Dulina14/-A-multi-RF-head-receiver-array-for-AI-native-sensing-and-communications/docs/group-documents/One_Page_Abstract.docx

# A Multi-RF-Head Receiver Array for AI-Native Integrated Sensing and Communications

D. M. B. P. Anuradha, W. A. A. P. Weragoda, R. P. D. D. H. Ranaweera, and P. I. U. Peiris

Department of Electronic and Telecommunication Engineering, University of Moratuwa, Sri Lanka

Supervisors: Prof. Arjuna Madanayake and Dr. Chamira U. S. Edussooriya

Emerging wireless platforms increasingly require the same radio infrastructure to support high-data-rate communications, environmental sensing, spectrum monitoring, localization, and target classification. Conventional implementations commonly use separate RF front ends for these functions, increasing hardware duplication and limiting cross-band experimentation. This project proposes a modular multi-RF-head receiver array for integrated sensing and communications (ISAC), with a common, software-configurable processing platform that can be adapted to communication, radar, and spectrum-intelligence experiments.

The proposed hardware covers approximately 0.8-8 GHz through four band-oriented RF heads: 0.8-1.6 GHz, 1-3 GHz, 2-8 GHz, and 5.7-6.0 GHz. Broadband Vivaldi arrays are considered for the wideband heads, while a 16-element microstrip patch array is investigated near 5.8 GHz to provide the directive gain and spatial selectivity required for unmanned-aerial-vehicle sensing. Each head combines input protection, low-noise amplification, RF switching, tunable or band-select filtering, low-phase-noise frequency conversion, and programmable gain. The design targets a receiver noise figure below 2 dB and an instantaneous bandwidth of up to 400 MHz, with synchronized intermediate-frequency or baseband outputs connected to high-speed data conversion and embedded control through USB or Ethernet.

The digital processing chain will support conventional communication waveforms together with orthogonal time frequency space (OTFS) modulation for delay-Doppler-domain ISAC. Beamforming and range-Doppler processing will be used to estimate range, radial velocity, direction of arrival, and micro-Doppler signatures, while data-driven models will be investigated for drone detection and classification. Communication performance will be assessed using signal-to-noise ratio, error vector magnitude, bit-error rate, and throughput. Sensing performance will be assessed using probability of detection, probability of false alarm, range/velocity/angle resolution and accuracy, update rate, and robustness to clutter. Antenna and array measurements will include impedance bandwidth, realized gain, radiation efficiency, beamwidth, sidelobe level, grating-lobe behavior, and inter-element isolation.

Validation will proceed from RF cascade and link-budget analysis to circuit and full-wave simulation, PCB implementation, and laboratory measurements using a vector network analyzer, calibrated signal sources, spectrum and noise-figure measurements, and controlled communication and sensing targets. The expected outcome is a reconfigurable experimental receiver that consolidates multi-band RF acquisition, array processing, OTFS-based sensing, and AI-assisted inference in one platform. It will provide a practical testbed for studying the trade-offs among coverage, sensitivity, angular resolution, waveform design, and implementation complexity in future ISAC systems.

Keywords - Integrated sensing and communications, multi-band receiver, RF front end, antenna array, OTFS, micro-Doppler, UAV detection.
