Dulina14/-A-multi-RF-head-receiver-array-for-AI-native-sensing-and-communications/docs/group-documents/Feasibility_Presentation.pdf

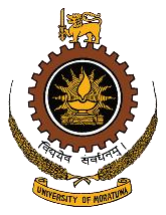
[picture p12: figure]
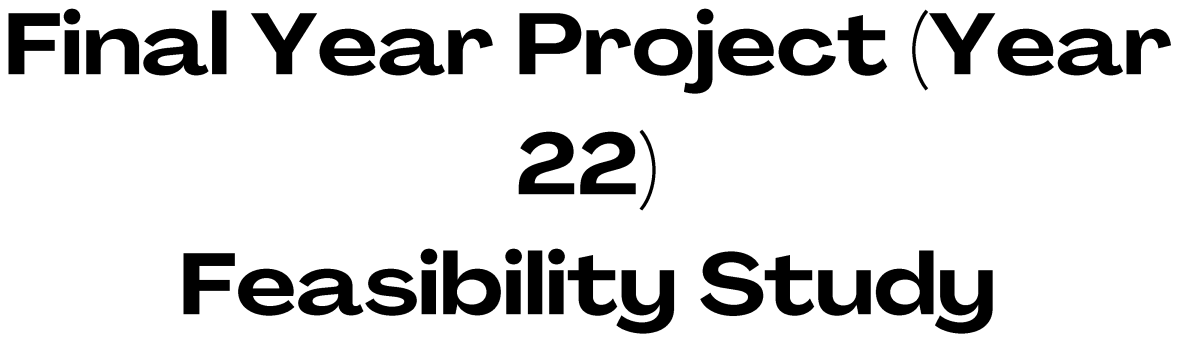
[picture p13: figure]
Final Year Project (Year 22) Feasibility Study
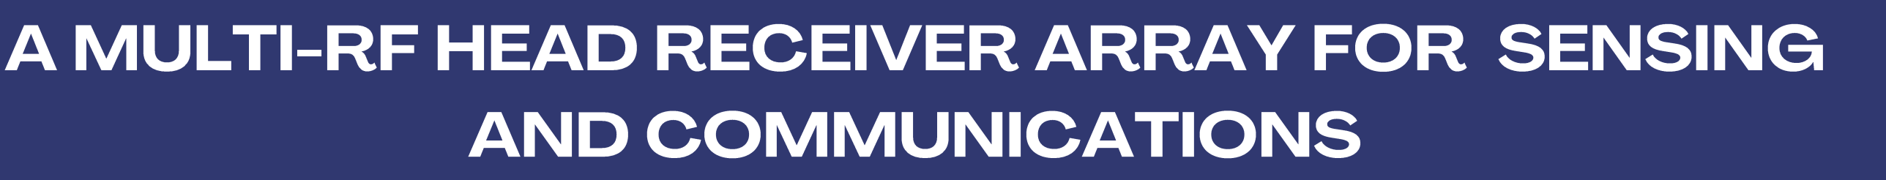
[picture p14: figure]
AND COMMUNICATIONS

A MULTI - RF HEAD RECEIVER ARRAY FOR SENSING

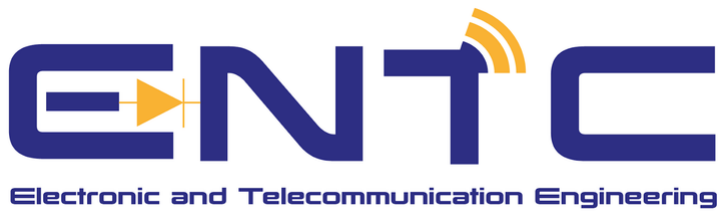
[picture p15: figure]

Group No.20 Members :
Ranaweera R.P.D.D.H.
Weragoda W.A.A.P.
Anuradha D.M.B.P.
Peiris P.I.U.

220511N
220692R
220036L
220452H

Supervisors :
Prof. Arjuna Madanayake
Dr. Chamira U. S. Edussooriya

1

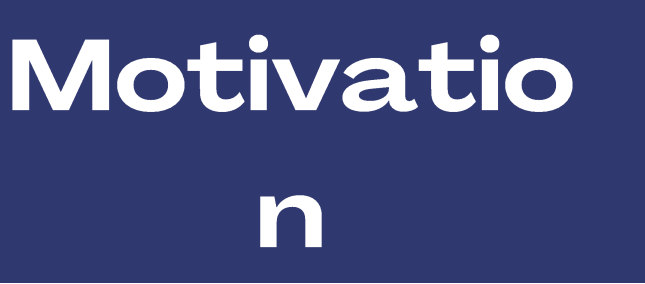
[picture p16: figure]
Motivatio n

Future promising 6G communication model expects seamless connectivity and awareness of its surroundings.

Integrated sensing and
communication (ISAC) can enable simultaneous communication and sensing functionality, promising seamless connectivity[1].

2

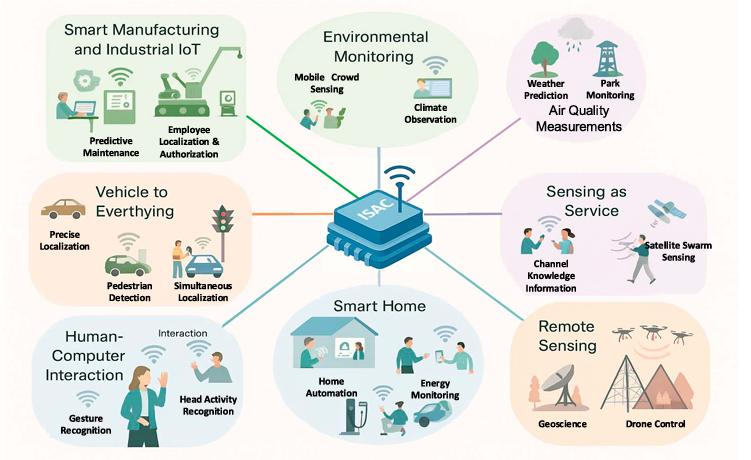
[picture p17: figure]

[1] K. Wu, Y. Bigdeli, S. A. Keivaan, J. Deng and P. Burasa, "Integrated Sensing and Communication (ISAC) Transceiver: Hardware Architectures, Enabling Technologies, and Emerging Trends," in IEEE Journal of Selected Topics in Electromagnetics, Antennas and Propagation, vol. 1, no. 1, pp. 37-64, Sept. 2025.

ISAC - Integrated Sensing and Communication,

- employs a shared hardware platform
- utilize shared waveform
- unified signal processing chain

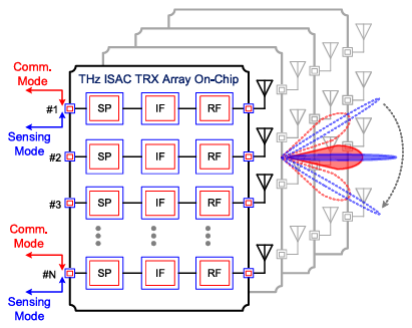
[picture p18: figure]

[1] K. Wu, Y. Bigdeli, S. A. Keivaan, J. Deng and P. Burasa, "Integrated Sensing and Communication (ISAC) Transceiver: Hardware Architectures, Enabling Technologies, and Emerging Trends," in IEEE Journal of Selected Topics in Electromagnetics, Antennas and Propagation, vol. 1, no. 1, pp. 37-64, Sept. 2025.

Illustration of ISAC concept to perform simultaneous sensing and wireless
data communication[1].

3

4

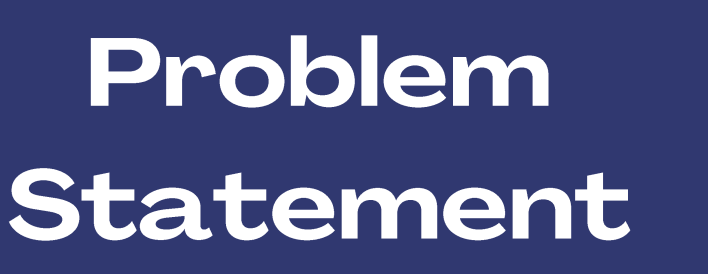
[picture p19: figure]
Problem Statement

Current ISAC receivers lack flexible multi-band communication capability while efficiently sharing common hardware [1].

[1] K. Wu, Y. Bigdeli, S. A. Keivaan, J. Deng and P. Burasa, "Integrated Sensing and Communication (ISAC) Transceiver: Hardware Architectures, Enabling Technologies, and Emerging Trends," in IEEE Journal of Selected Topics in Electromagnetics, Antennas and Propagation, vol. 1, no. 1, pp. 37-64, Sept. 2025.

Why do we need multiple bands ?
- It’s difficult to optimize hardware for both sensing and communication over a wide continuous bandwidth [1].
- But it’s possible to optimize for fragmented bands [1].

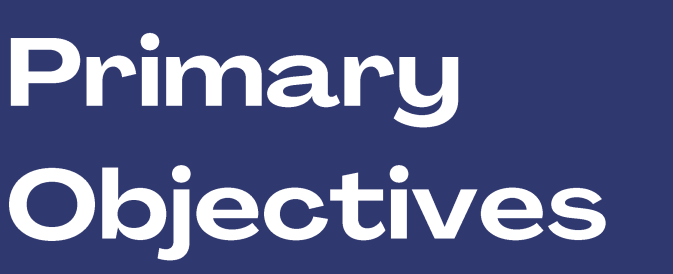
[picture p20: figure]
Primary Objectives

Building a multi-head radio frequency (RF) chain and three antenna arrays for both sensing and communication without much hardware redundancy.

Implement simultaneous communication and unmanned aerial vehicle(UAV) detection.

5

Multi-head RF receiver
- Simulate and design of antenna arrays (two Vivaldi arrays and one patch antenna array).
- Simulate and design of RF chains for communication and sensing.
- Perform testing and verify the functionality of the receiver in the field.

Communication and sensing implementation
- Verify sensing capabilities using orthogonal time frequency space modulation (OTFS).
- Enable multi-band communication.

6

Scop
e

- Beam-forming is excluded because it requires multiple synchronized RF chains and significantly increases cost, hardware complexity, calibration, and processing requirements; it is considered as a future extension.

7

Out of Scope

Analog or digital beam-forming

- Multi-RF head receiver array with a single RF channel PCB, antennas, and RF front ends.
- Embedded software and processing for receiver control, configuration, and received-data processing.
- Conference or journal paper submitted to a recognized publication venue.

8

9

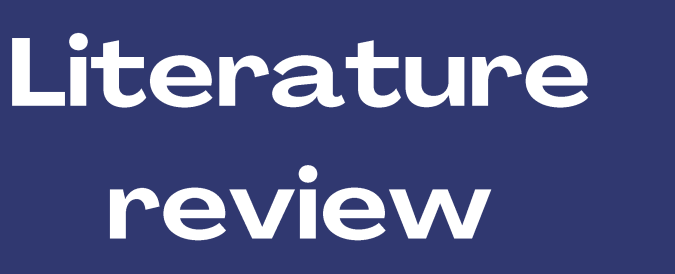
[picture p21: figure]
Literature review
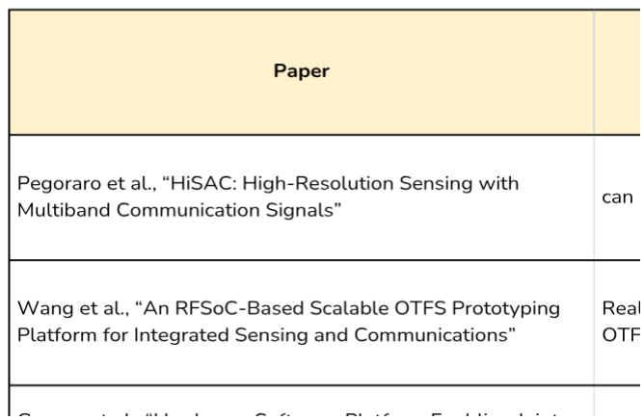
[picture p22: figure]
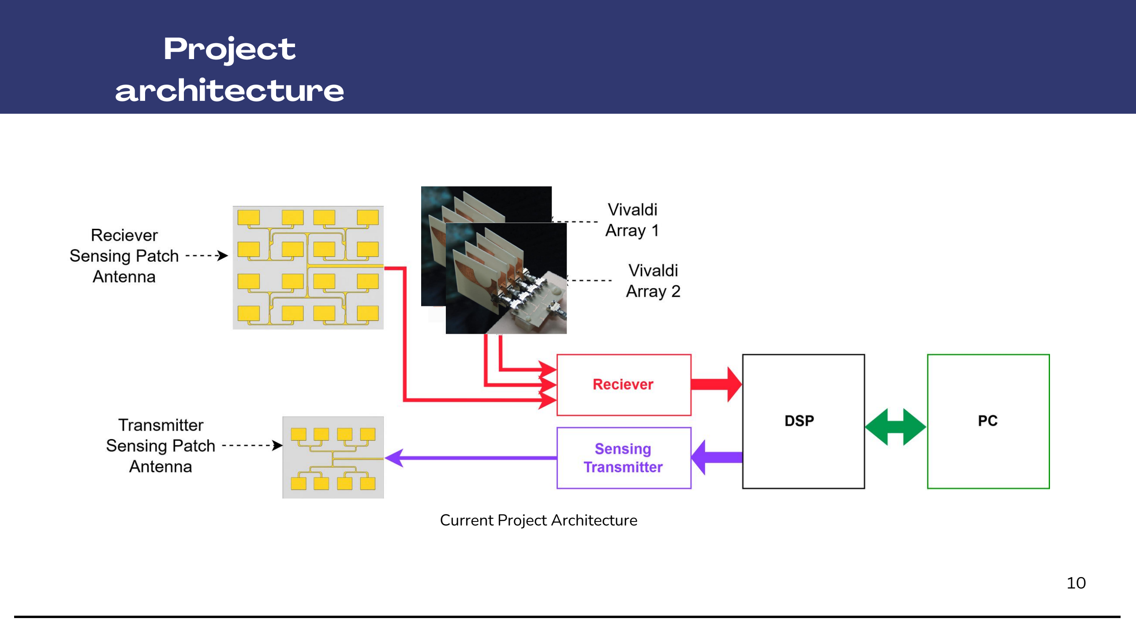
[picture p23: page 10]

Current Project Architecture

10

Project
architecture

11

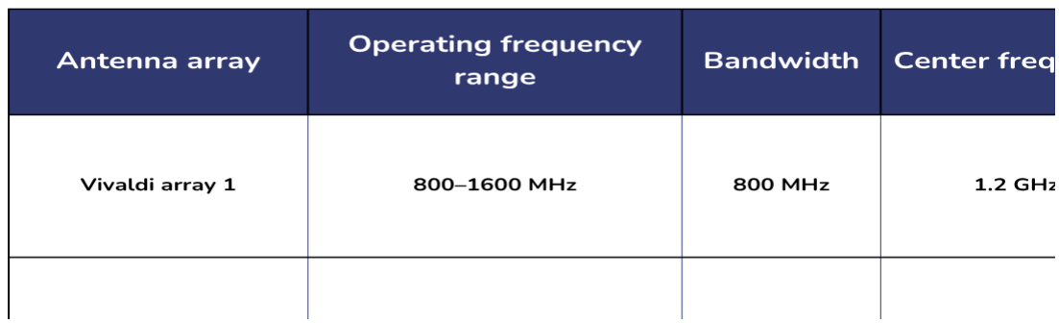
[picture p24: figure]

Design criterion Patch antenna | Rectangular patch | Yagi-Uda | Slot antenna
design Basic structure | Conductive patch printed above a | Driven element with reflector and | Slot cut into a conductive
Why do need to use a patch antenna ? | ground plane | directors | ground plane
Bandwidth | Naturally narrowband | Narrow to moderate bandwidth | Narrowband or broadband
Physical profile | Low and compact | Longer and protruding | Low and planar
PCB integration/ Fabrication | Excellent/ simple | Normally requires separate mechanical structure | Excellent/ PCB-compatible
Main advantage | Compact, planar, and easy to integrate | High directional gian | Low profile with flexible geometry

12

Why do we use an antenna array of 16 element patches ?

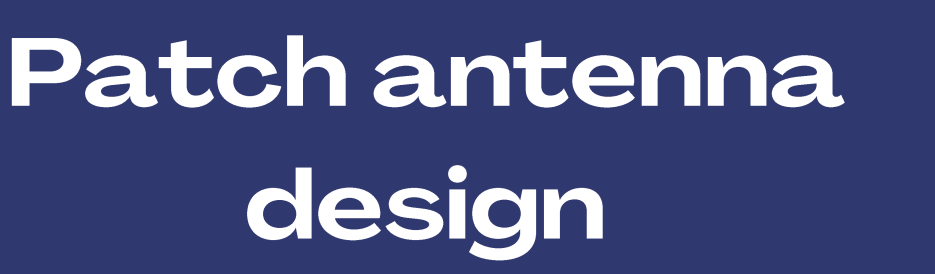
[picture p25: figure]
Patch antenna design
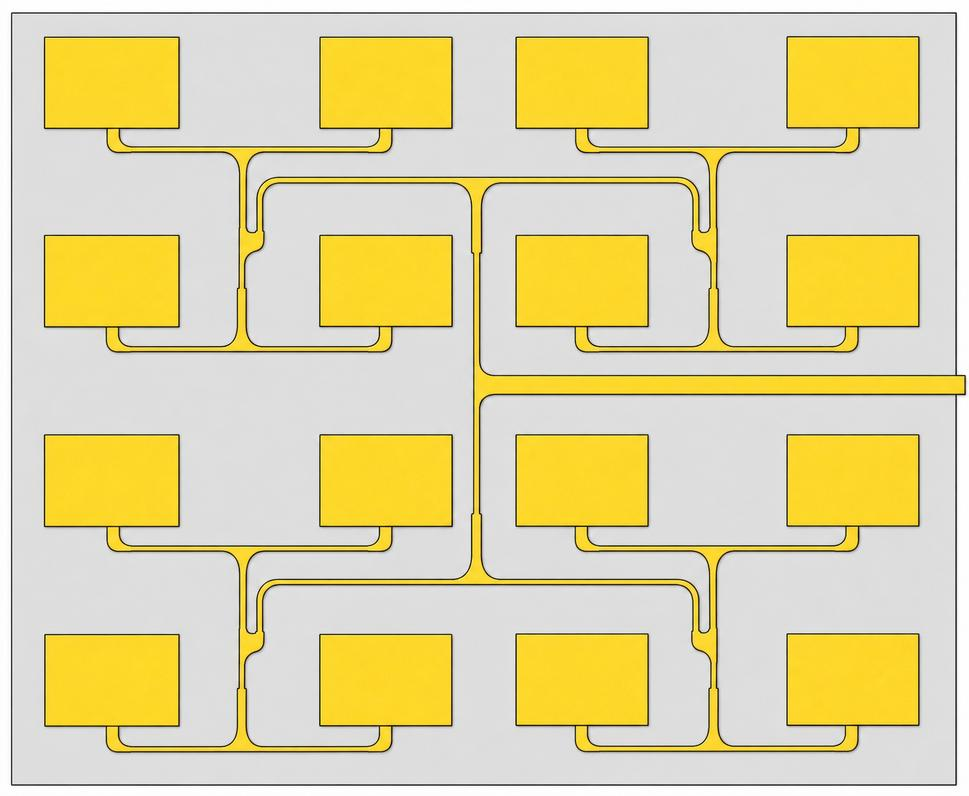
[picture p26: figure]

Proposed patch antenna array design

- The proposed design is a 16-element (4 × 4) corporate edge-fed microstrip patch antenna array, impedance-matched using quarter-wave transformers.
- An antenna array provides a higher directivity and gain, narrower beamwidth, controllerable beam direction and control over sidelobes and nulls etc.
- Ideally, D_”array” ≈ N * D_"element" .
- A 4 x 4 array provides benefits such as two dimensional beam control, two-axis steering, balanced E/H beamwidths, compact aspect ratio etc.

13

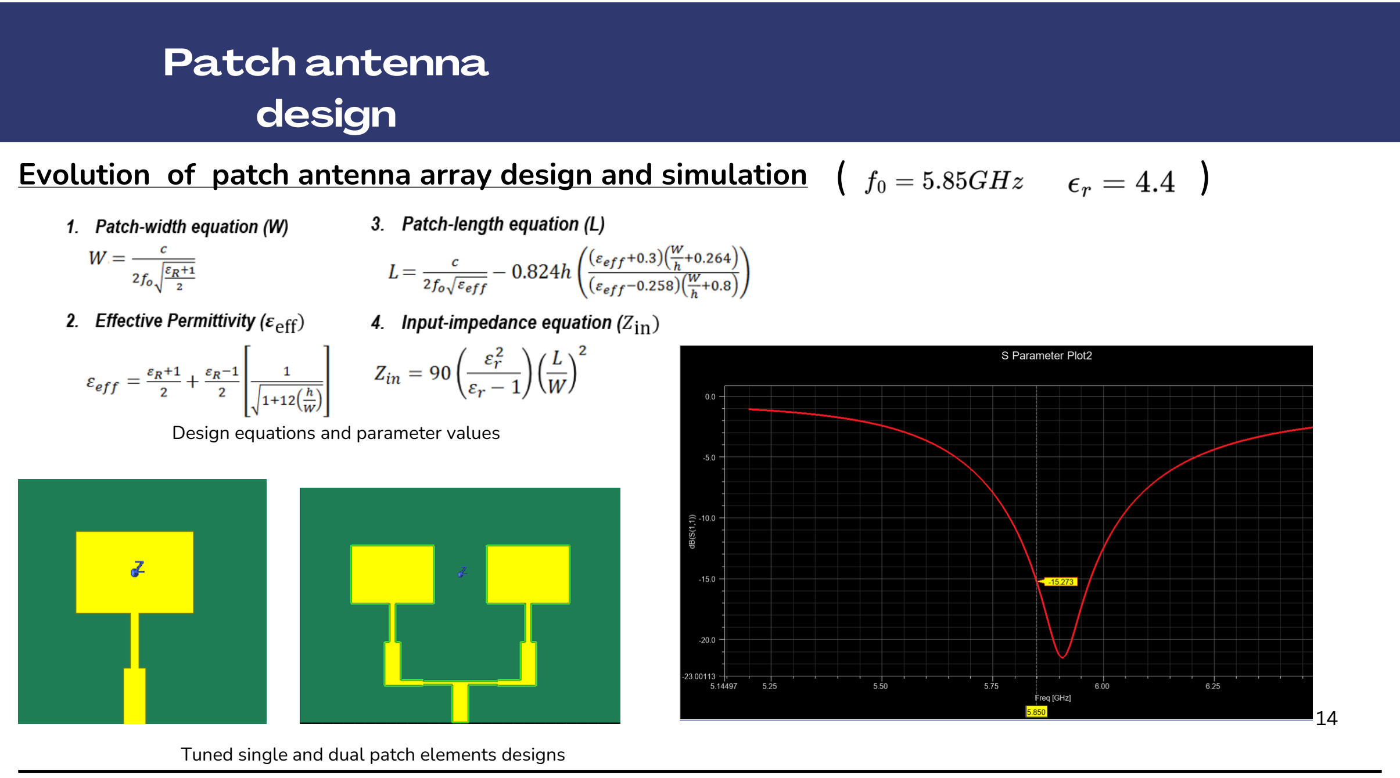
[picture p27: page 14]

Tuned single and dual patch elements designs

Evolution of patch antenna array design and simulation

Design equations and parameter values

14

Patch antenna
design
( | )

Design criterion Antipodal Vivaldi antenna design | Horn antenna | Log Periodic antenna | Tapered-Slot Vivaldi | Antipodal Vivaldi
Basic structure Why do need to use a Vivaldi antenna? | Flared waveguide | Multiple driven and parasitic elements | Exponentially tapered slot | Overlapping antipodal conductors with tapered slot
Bandwidth | Very wide | Very wide | Ultra-wideband | Ultra-wideband
Physical profile | Bulky and large | Long and protruding | Low-profile and planar | Low-profile and planar
PCB integration/ fabrication | Difficult | Moderate | PCB-compatible | PCB-compatible
Main advantage | High gain and directivity | Very wide frequency coverage | Wideband and low profile | Wideband, compact

15

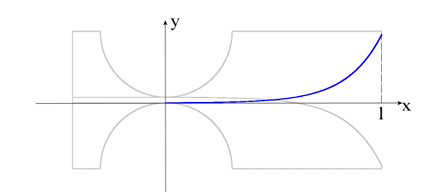
[picture p28: figure]

Why do we use an antipodal Vivaldi antenna?

- Wide-band operation with broad impedance and gain bandwidth.
- Having higher directivity due to tappered slot structure provide end-fire radiation.
- Smooth feed-to-radiator transition for improved impedance matching.
Antenna array: Higher resulting gain of main lobe and can obtain lower side lobes.

16

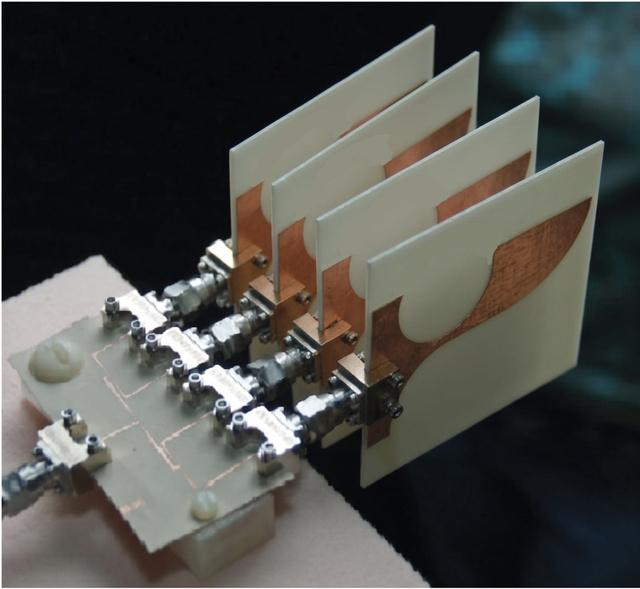
[picture p29: figure]

G. Vinci and R. Weigel, "Multiband Planar Vivaldi Antenna for Mobile Communication and Industrial Applications," 2010 International Conference on Electromagnetics in Advanced Applications, Sydney, NSW, Australia, 2010, pp. 93-96

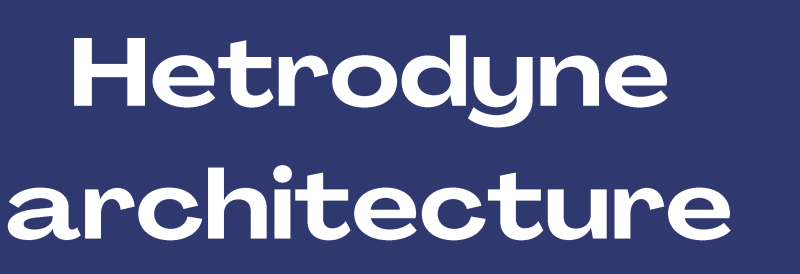
[picture p30: figure]
Hetrodyne architecture
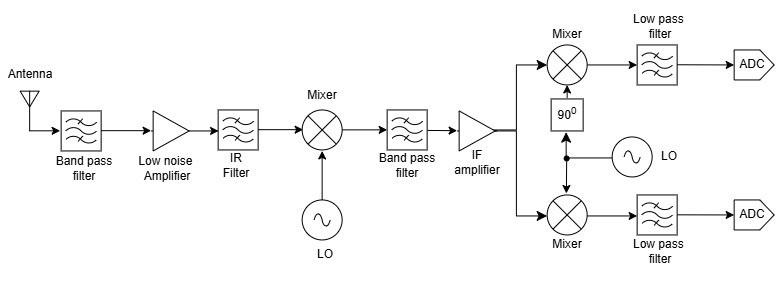
[picture p31: figure]

- High selectivity through RF/IF filtering and amplification.
- Multiple frequency conversions provide flexible gain distribution and good interference rejection.
- Need to apply additional filters for image-rejection.
B. Razavi, “RF Microelectronics,” 2nd Edition, Prentice Hall Communications Engineering and Emerging Technologies Series, 2012. | 17

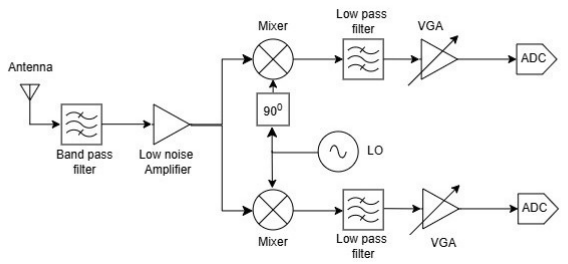
[picture p32: figure]

- Directly converts RF to baseband.
- Simple, low-power, and highly integrated architecture suitable for multi-standard applications.
- DC offset, flicker noise and IQ mismatch can degrade the received signal.
B. Razavi, “RF Microelectronics,” 2nd Edition, Prentice Hall Communications Engineering and Emerging Technologies Series, 2012. | 18

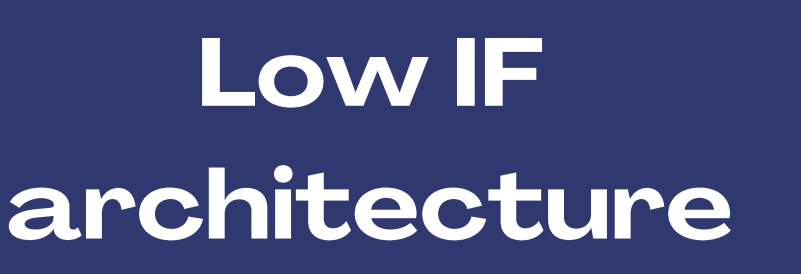
[picture p33: figure]
Low IF architecture
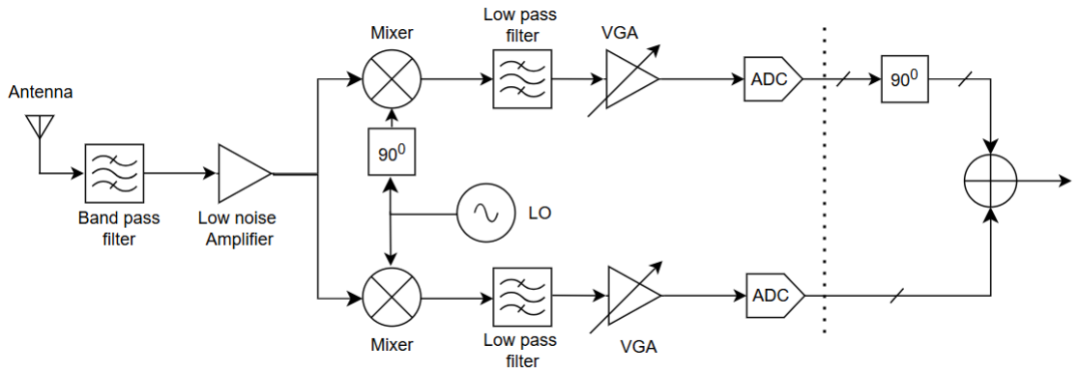
[picture p34: figure]

- Converts RF to a low intermediate frequency.
- Image frequencies reappear because the IF is non-zero.
- Image-rejection filtering or mixers are required, increasing implementation complexity.
B. Razavi, “RF Microelectronics,” 2nd Edition, Prentice Hall Communications Engineering and Emerging Technologies Series, 2012. | 19

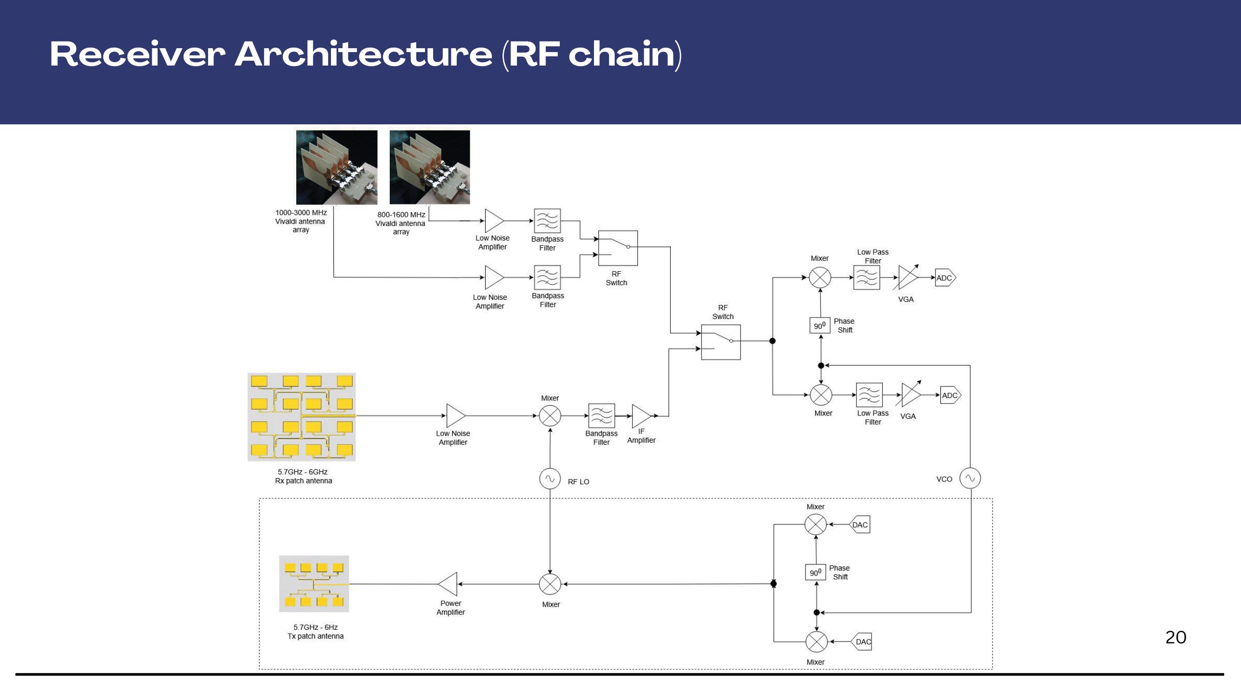
[picture p35: page 20]

20

Receiver Architecture (RF chain)

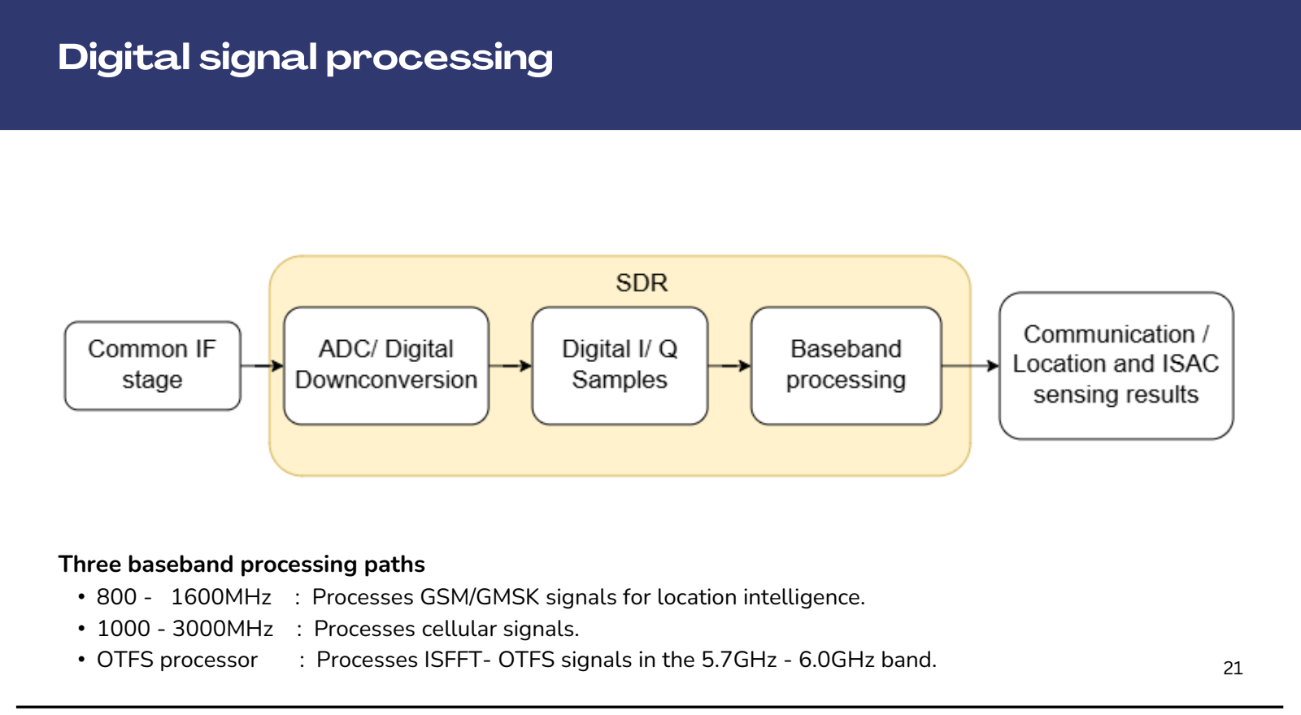
[picture p36: page 21]

Three baseband processing paths
- 800 - 1600MHz : Processes GSM/GMSK signals for location intelligence.
- 1000 - 3000MHz : Processes cellular signals.
- OTFS processor | : Processes ISFFT- OTFS signals in the 5.7GHz - 6.0GHz band. | 21

Digital signal processing

The problem with standard signals, State-of-the-art Orthogonal Frequency Division Multiplexing (OFDM) is unstable to severe Doppler shifts which cause Inter-Carrier Interference (ICI).

OTFS solves this by mapping the data into the Delay-Doppler domain.

- e.g., fast moving targets like drones creates sever Doppler shifts

22

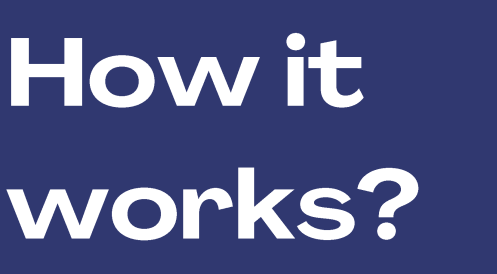
[picture p37: figure]
How it works?
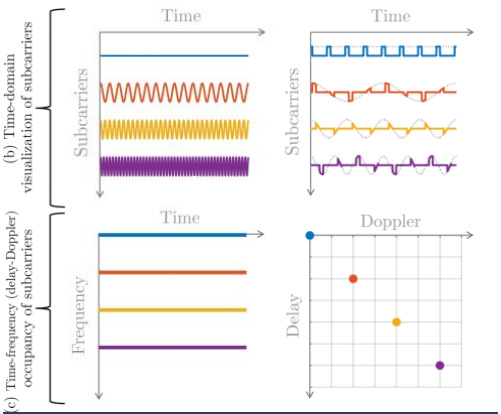
[picture p38: figure]

OFDM | OTFS

It modulates information onto a localized pulse in Delay-Doppler domain, which immunes for larger Doppler shifts.

Delay-Doppler domain - A coordinate system that maps channel paths depending on their path delay and Doppler shifts

represntation of OFDM and OTFS on time and time frequency domain

Rou, Hyeon Seok & Ranasinghe, Kuranage Roche Rayan & Savaux, Vincent & Abreu, Giuseppe & G., David & Masouros, Christos. (2026). Affine Frequency Division Multiplexing (AFDM) for 6G: Properties, Features, and Challenges. IEEE Communications Standards Magazine. 10. 216-225. 10.1109/MCOMSTD.2025.3643183.

Therefore OTFS become prominent in future highly dynamic communication topologies.

23

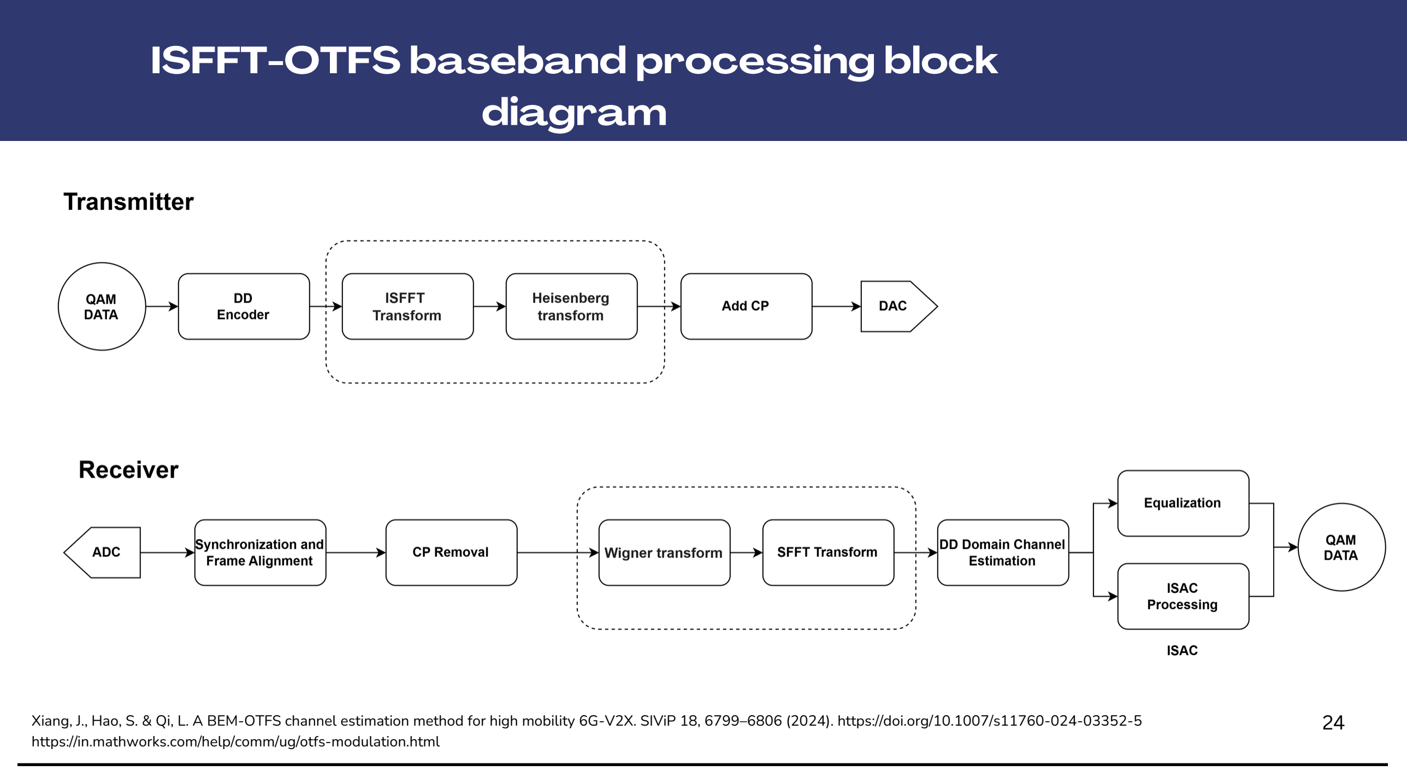
[picture p39: page 24]

Xiang, J., Hao, S. & Qi, L. A BEM-OTFS channel estimation method for high mobility 6G-V2X. SIViP 18, 6799–6806 (2024). https://doi.org/10.1007/s11760-024-03352-5https://in.mathworks.com/help/comm/ug/otfs-modulation.html

24

ISFFT -OTFS baseband processing block diagram

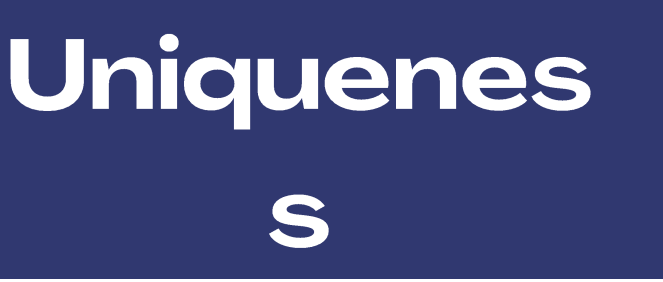
[picture p40: figure]
Uniquenes s

Multifunctional receiver
platform
1. Can accommodate multiple communication bands
- e.g.,
⚬ 800MHz - 1600MHz band - GSM communication ⚬ 1000MHz - 3000MHz band - Wi-Fi and Bluetooth communication
1. OTFS modulation is used for sensing application

25

Telecommunicatin
operators

Universities and
research
institutions.

Defense and
security

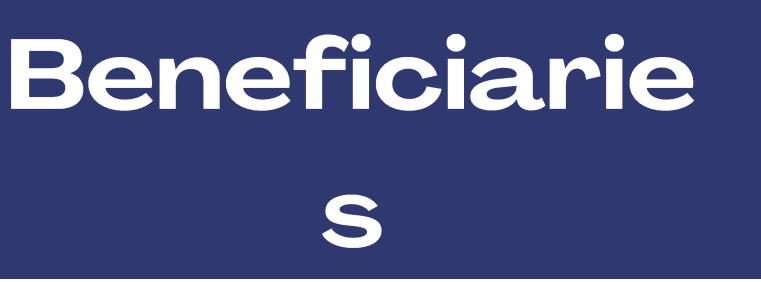
[picture p41: figure]
Beneficiarie s

organizations

Critical
infrastructure
operators

26

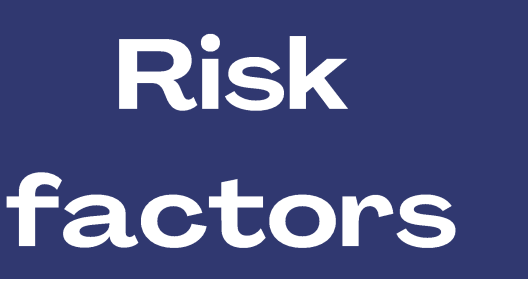
[picture p42: figure]
Risk factors

- Mutual coupling & RF interference ⚬ Risk: nearby antennas interfere with each other.
⚬ Mitigation: optimize spacing and isolation.
- Time constraints
⚬ Risk: delay in component procurement, manufacturing, or model convergence.
⚬ Mitigation: parallel task execution and phased integration to reduce bottlenecks.
- Legal / regulatory feasibility ⚬ Risk: transmitter power may surpass the power limitations imposed by the TRCSL. ⚬ Mitigation: carefully design the system not to violate power regulations.
- Hardware failure
⚬ Risk: PCB fabrication defects, antenna mismatches, or component damage.
⚬ Mitigation: simulate all designs thoroughly and fabricate from certified company . | 27

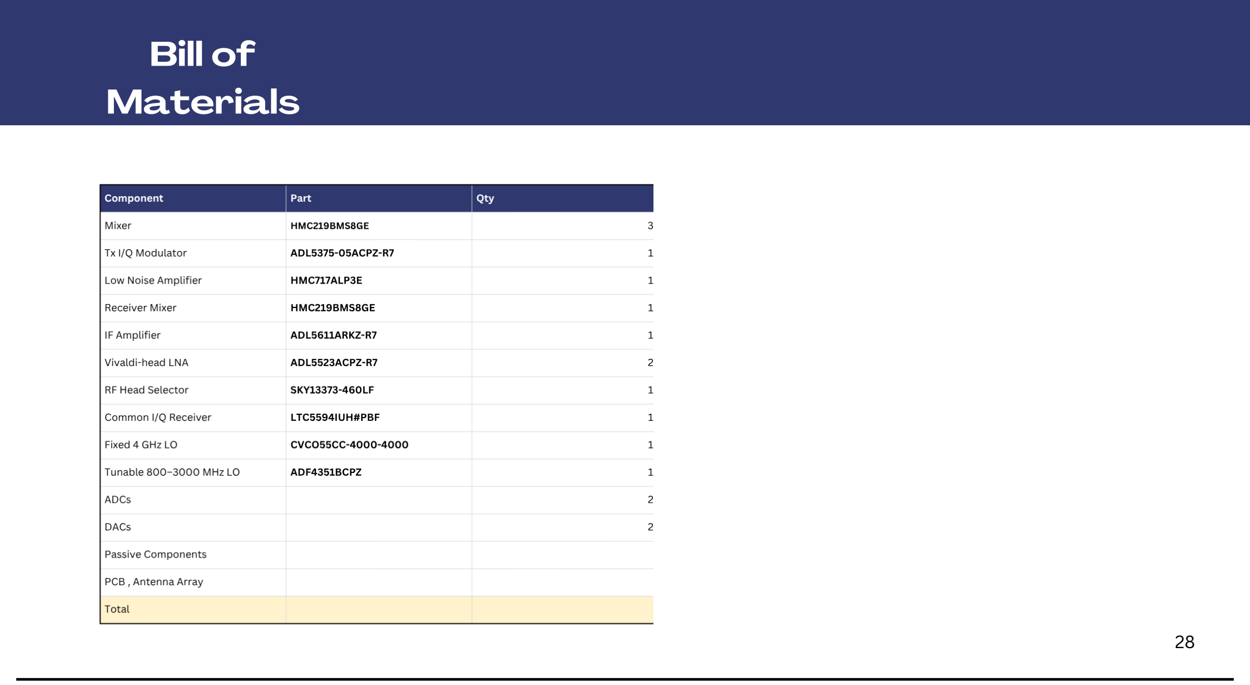
[picture p43: page 28]

28

Bill of
Materials

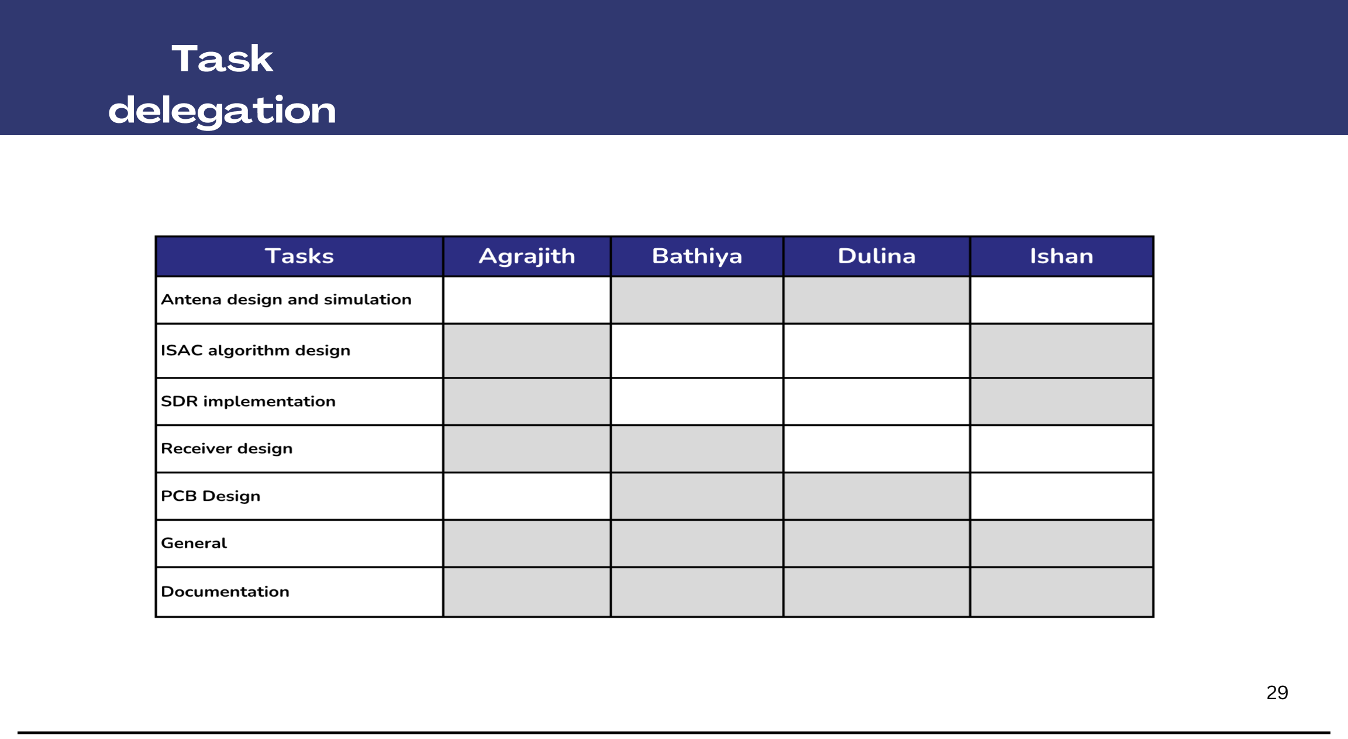
[picture p44: page 29]

29

Task
delegation

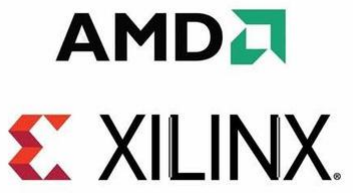
[picture p45: figure]

- RF simulation tools (ADS, HFSS), Altium PCB designer.
- Xilinx Vivado/ Vitis HLS.
- MATLAB/Python-based signal processing.

Software tools

- RF LNAs, mixers, switches, tunable filters, and IF amplifiers
- Spectrum analyzer, VNA, signal generator, and RF measurement equipment
- FPGA , SDR for digital signal processing

Hardware tools

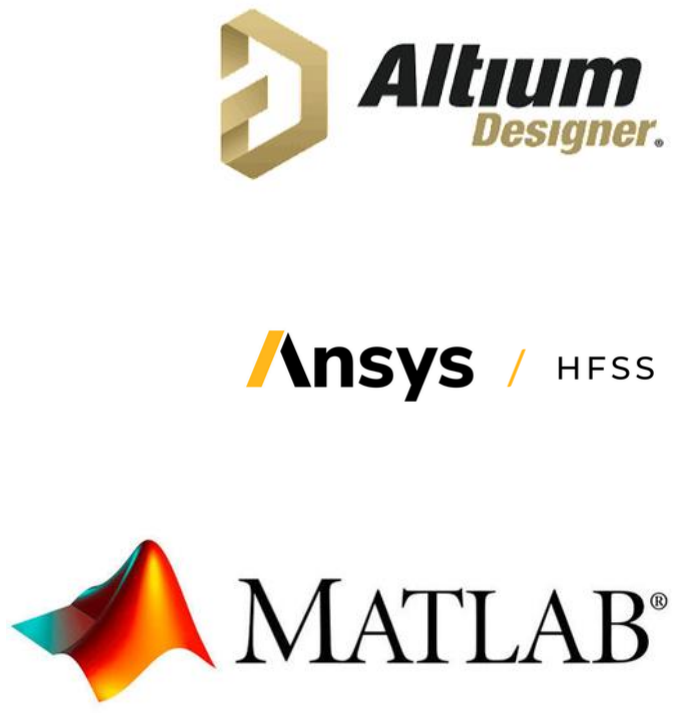
[picture p46: figure]

30
LNA- Low Noise Amplifier , IF - Intermediate Frequency , VNA - Vector Network Analyzer , SDR - Software Define Radio , FPGA - Field Programmable Gate Array

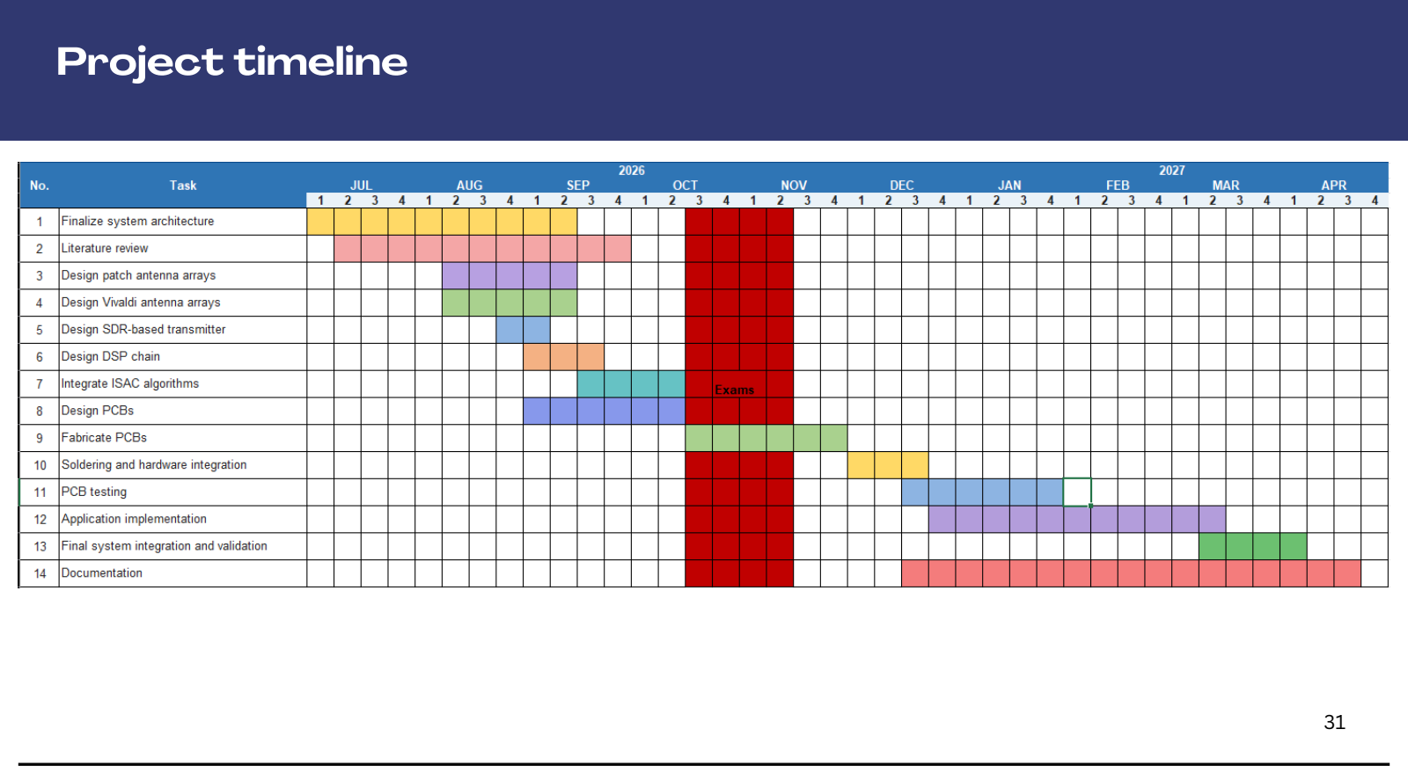
[picture p47: page 31]

31

Project timeline

32

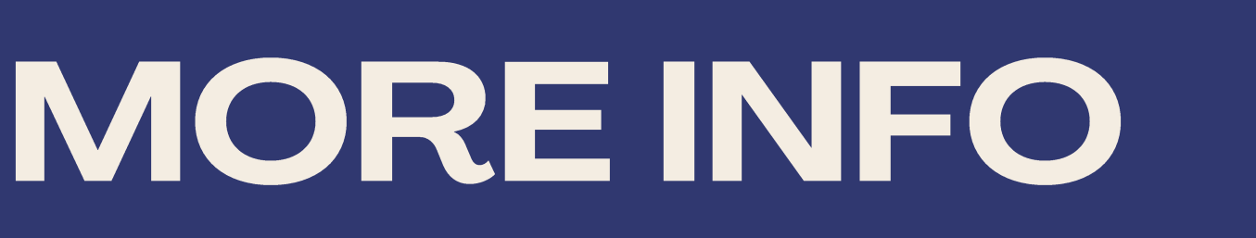
[picture p48: figure]
MORE INFO
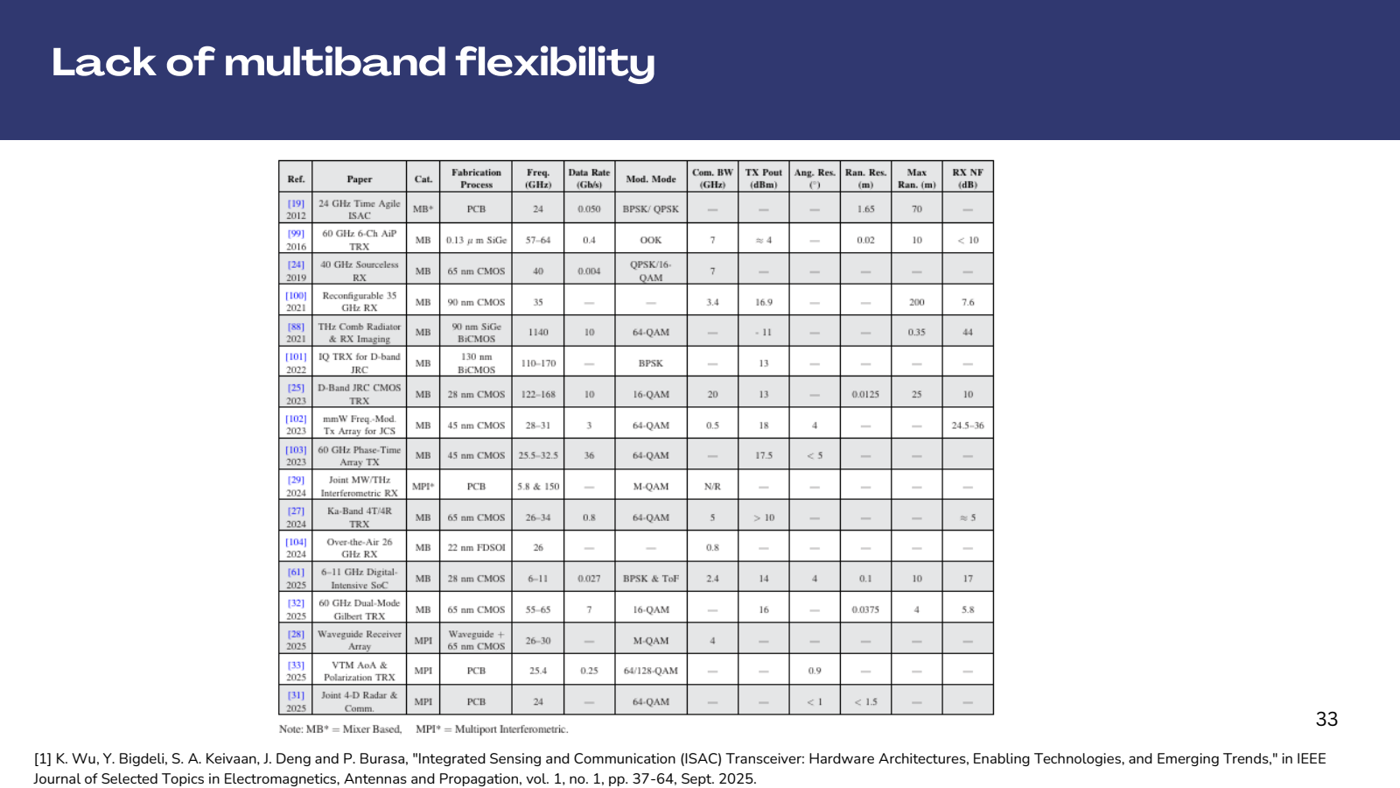
[picture p49: page 33]

33

Lack of multiband flexibility

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

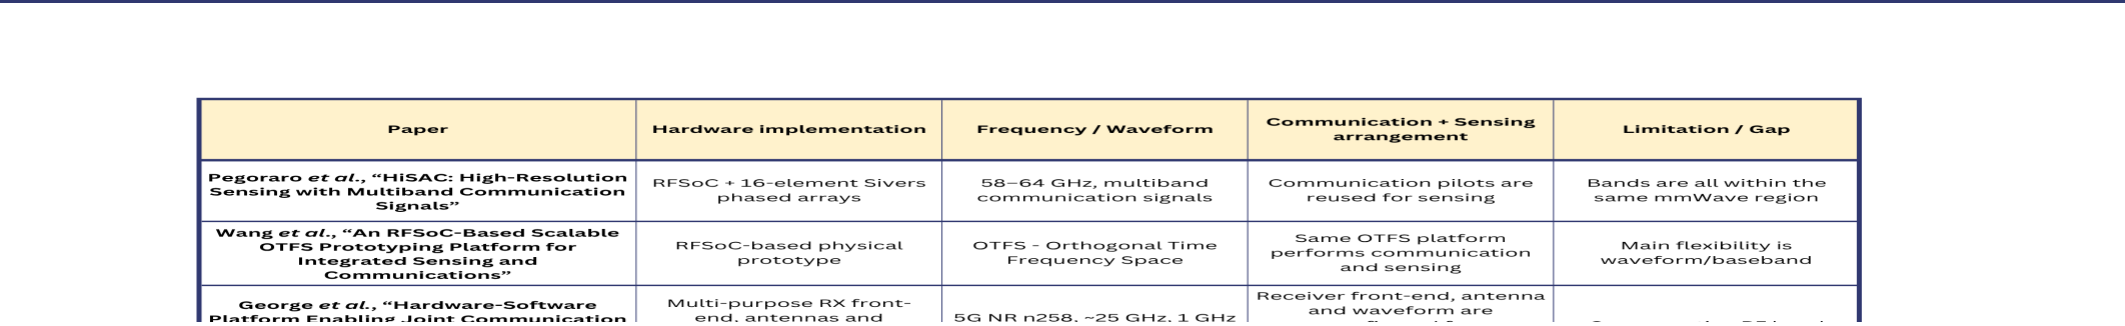
[picture p50: figure]

34

35

- In antenna array the spacing between two antennas decided by the upper bound frequecy wave length of the desired band. (Sampling the wave phases without aliasing)
- Antenna array elements are equally spaced (linear array)

800MHz - 6000MHz band
d - space between two
elements
lambda - free space wave length of the upper bound frequency of the frequency band
- Therefore the spacial resolution for the lower frequencies is lower. For lower frequencies need a larger electrical aperture. Need a larger number of antenna elements.
- It is too costly

Solution :- Divide the the frequency range into proper sub ranges and allocate differnt antenna arrays.

https://en.wikipedia.org/wiki/Antenna_array

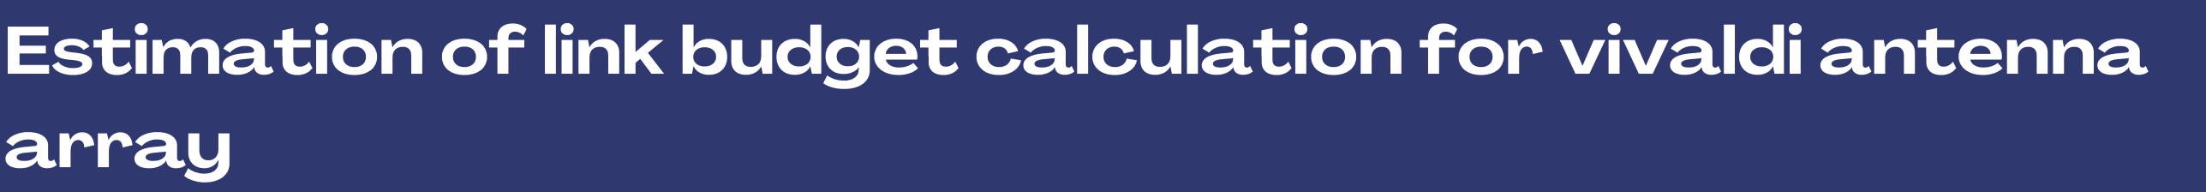
[picture p51: figure]
array

https://www.analog.com/en/resources/technical-articles/radio-linkbudget-calculations-for-ismrf-products.html? | 36

Free space path loss for 2.4 GHz frequency signal

FSPL = 20 log (4π(15)/0.125)
= 63.58 dB

PR = PT + GT + GR −FSPL (In dBm) PR = 6dB - 63.58dB

- Hopely recieve signals from 10-15 meters away
PR Received power | R range
PT Transmitted power | λ wavelength
GT Transmitter antenna gain | GR Receive antenna gain

Estimation of link budget calculation for vivaldi antenna

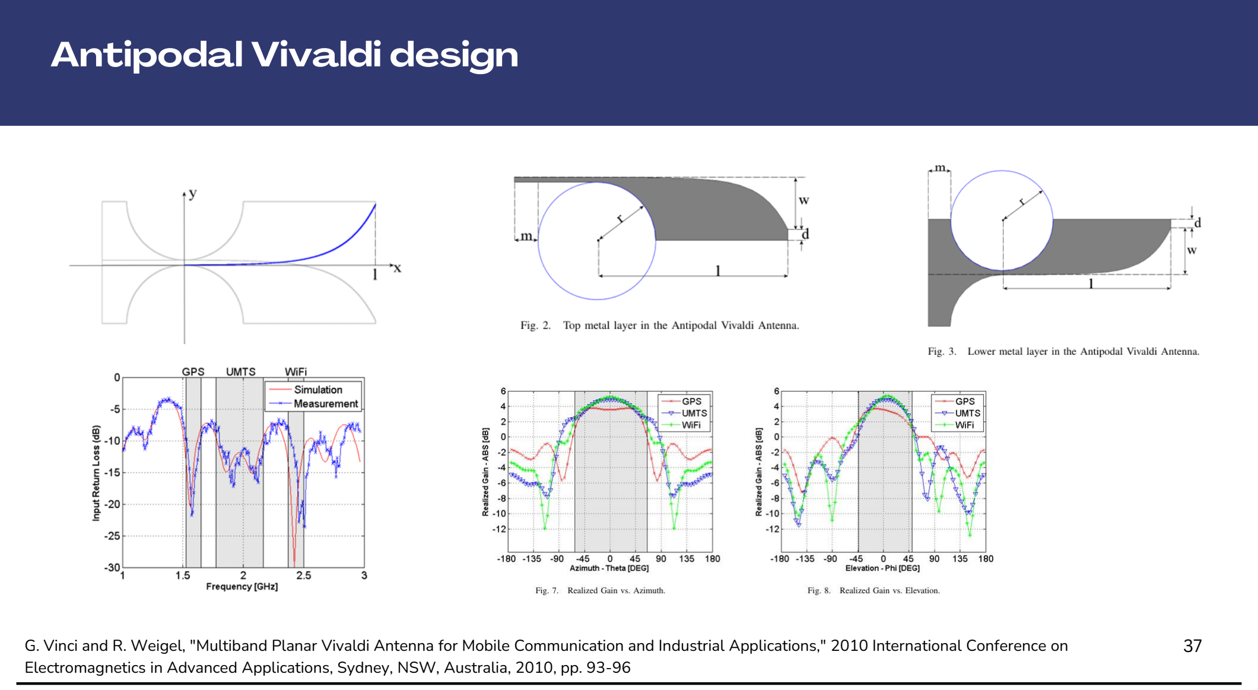
[picture p52: page 37]

G. Vinci and R. Weigel, "Multiband Planar Vivaldi Antenna for Mobile Communication and Industrial Applications," 2010 International Conference on | 37
Electromagnetics in Advanced Applications, Sydney, NSW, Australia, 2010, pp. 93-96

Antipodal Vivaldi design

38

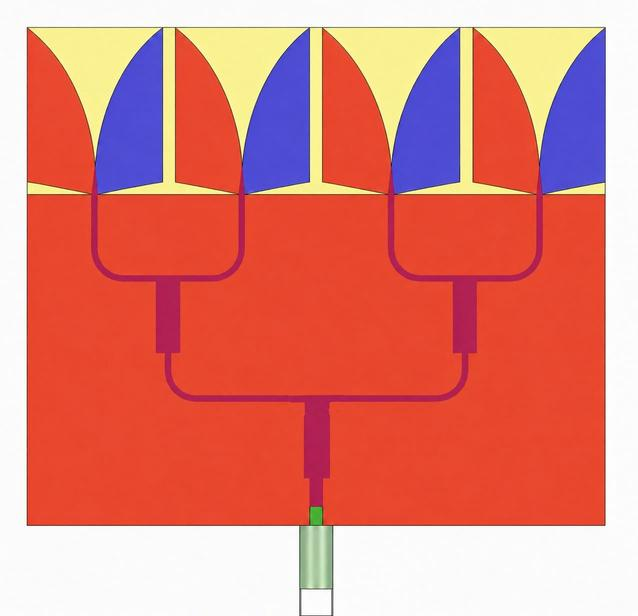
[picture p53: figure]

1 | 2

The second orientation is preferred because it allows the inter-element spacing d to be maintained close to the desired λ/2 spacing. In the first orientation, the physical dimensions of the Vivaldi elements constrain the placement, resulting in d>λ/2.

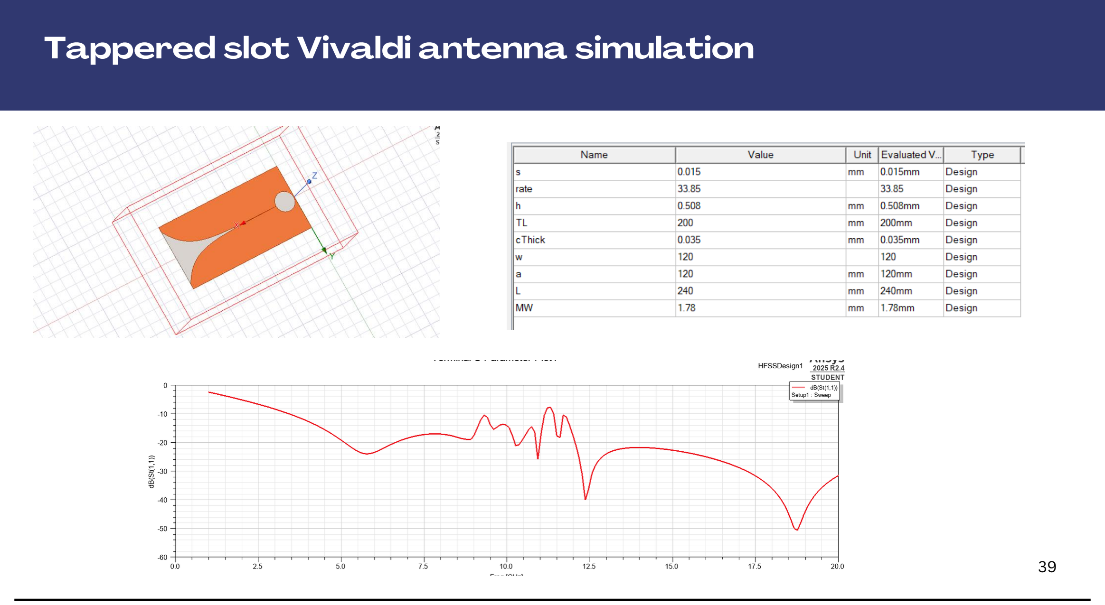
[picture p54: page 39]

39

Tappered slot Vivaldi antenna simulation

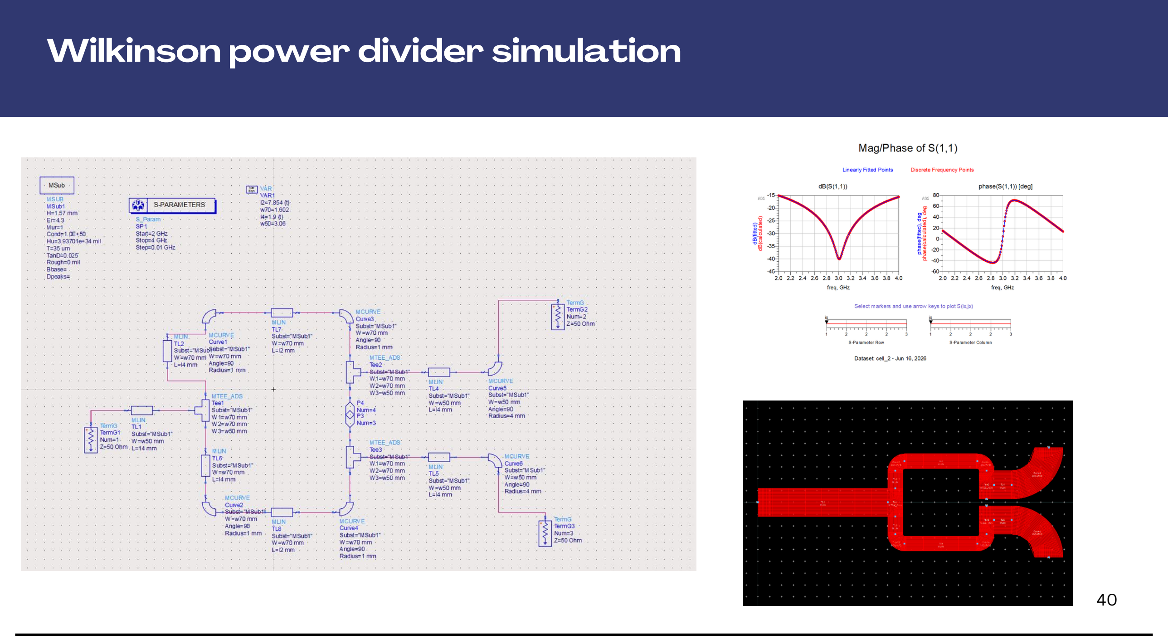
[picture p55: page 40]

40

Wilkinson power divider simulation

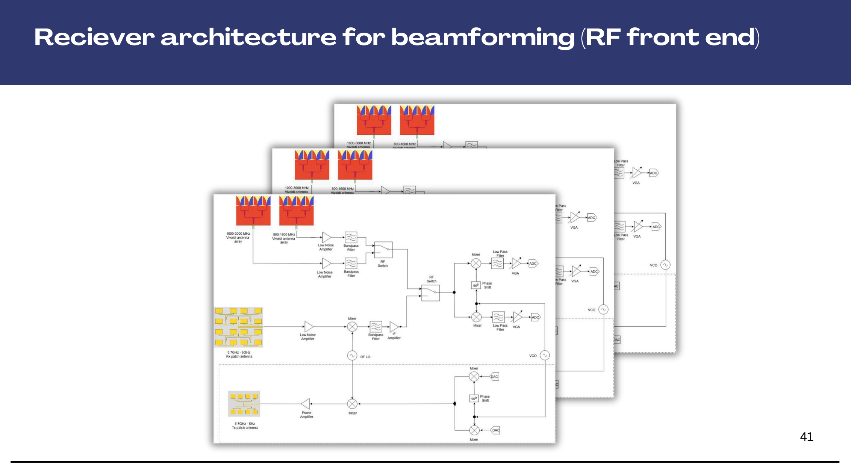
[picture p56: page 41]

Reciever architecture for beamforming (RF front end)

41

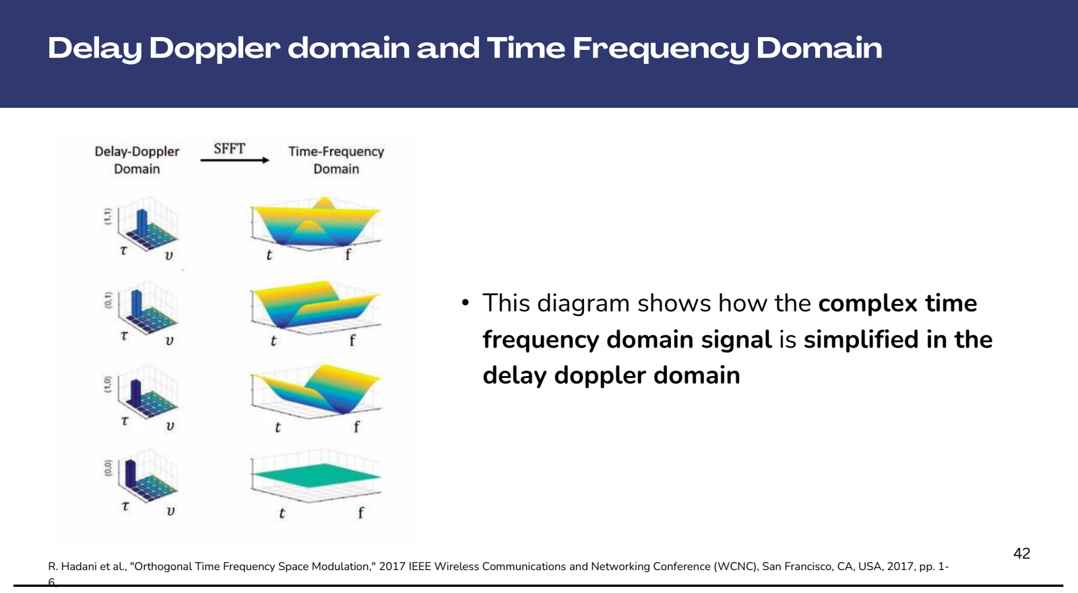
[picture p57: page 42]

42

Delay Doppler domain and Time Frequency Domain

R. Hadani et al., "Orthogonal Time Frequency Space Modulation," 2017 IEEE Wireless Communications and Networking Conference (WCNC), San Francisco, CA, USA, 2017, pp. 1-6,.
- This diagram shows how the complex time frequency domain signal is simplified in the delay doppler domain

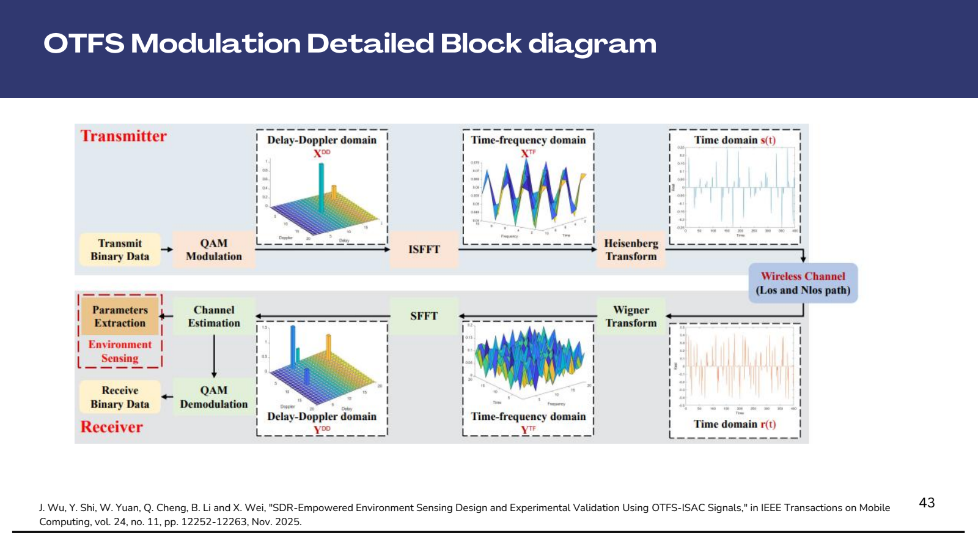
[picture p58: page 43]

43

OTFS Modulation Detailed Block diagram

J. Wu, Y. Shi, W. Yuan, Q. Cheng, B. Li and X. Wei, "SDR-Empowered Environment Sensing Design and Experimental Validation Using OTFS-ISAC Signals," in IEEE Transactions on Mobile Computing, vol. 24, no. 11, pp. 12252-12263, Nov. 2025.
