Dulina14/-A-multi-RF-head-receiver-array-for-AI-native-sensing-and-communications/signal-processing/references.md

# References – OTFS Drone Sensing

[← back to signal processing](README.md)

## Closest to "OTFS + drones"

- UAV Detection Based on OTFS ISAC System – IEEE Xplore: https://ieeexplore.ieee.org/document/11174465/
- OTFS ISAC SDR Implementation and Experiment Testing for UAV Micro-Doppler Analysis – IEEE Xplore: https://ieeexplore.ieee.org/document/11150790
- Luo *et al.*, "AirGuard: UAV and Bird Recognition Scheme for ISAC," 2026.
- Lu *et al.*, "ISAC-enabled Multiple Base Stations Cooperative UAV Detection," 2024.
- Wei *et al.*, "UAV's Rotor Micro-Doppler Feature Extraction Using Integrated Sensing and Communication Signal: Algorithm Design and Testbed Evaluation."

## OTFS radar algorithms (ISFFT style)

- P. Raviteja, K. T. Phan, Y. Hong, E. Viterbo, "Orthogonal Time Frequency Space (OTFS) Modulation Based Radar System," IEEE RadarConf 2019 – https://arxiv.org/abs/1901.09300
- L. Gaudio, G. Colavolpe, G. Caire, "On the Effectiveness of OTFS for Joint Radar Parameter Estimation and Communication," IEEE TWC 2020 – https://arxiv.org/abs/1910.01896
- OTFS Based Radar Sensing with Fractional Delay and Doppler Estimation – https://arxiv.org/abs/2301.09909
- Shtaiwi *et al.*, "Orthogonal Time Frequency Space for Integrated Sensing and Communication: A Survey," 2024 – https://arxiv.org/abs/2402.09637
- R. Hadani *et al.*, "Orthogonal Time Frequency Space Modulation," IEEE WCNC 2017.

## OTFS on FPGA / real hardware

- Isik, Nkomo, Das, Dandekar, "FPGA Implementation of OTFS Modulation for 6G" (ISFFT with Xilinx FFT IP, 64 × 64, RFSoC) – https://arxiv.org/abs/2310.09671
- Merouane *et al.*, "High-performance OTFS transmitter on FPGA: a hybrid HLS/VHDL design," *Integration*, 2026 (Virtex-7) – https://www.sciencedirect.com/science/article/abs/pii/S0167926025001993
- Wang, Ouyang, Zhang, Gao, "An RFSoC-Based Scalable OTFS Prototyping Platform for ISAC," IEEE TWC 2025 – https://ieeexplore.ieee.org/document/10974457
- Sivasankar, …, Madanayake, "Design and Test of AMD RFSoC-based Zak-OTFS Transceiver for ISAC at 3.5 GHz" (supervisor's group).
- Tihomorskis *et al.*, "SDR Experimental Validation of an OTFS-Based ISAC for Velocity Estimation," *Technologies*, 2026.

## Learning material

- Y. Hong, T. Thaj, E. Viterbo, *Delay-Doppler Communications: Principles and Applications*, Academic Press, 2022 (with MATLAB code) – https://www.mathworks.com/academia/books/delay-doppler-communications-hong.html
- Monash OTFS reference code (Raviteja, Hong, Viterbo; BSD-style licence) – https://ecse.monash.edu/staff/eviterbo/OTFS-VTC18/index.html
- MATLAB OTFS modulation example – https://www.mathworks.com/help/comm/ug/otfs-modulation.html
- J. Xiang, S. Hao, L. Qi, "A BEM-OTFS channel estimation method for high mobility 6G-V2X," *SIViP* 18, 6799–6806, 2024. doi:10.1007/s11760-024-03352-5

> Third-party code and papers are **linked, not copied**, into this repository. Please get them from the original authors.
