Dulina14/-A-multi-RF-head-receiver-array-for-AI-native-sensing-and-communications/antenna/images/early_concept_reconfigurable_array.png

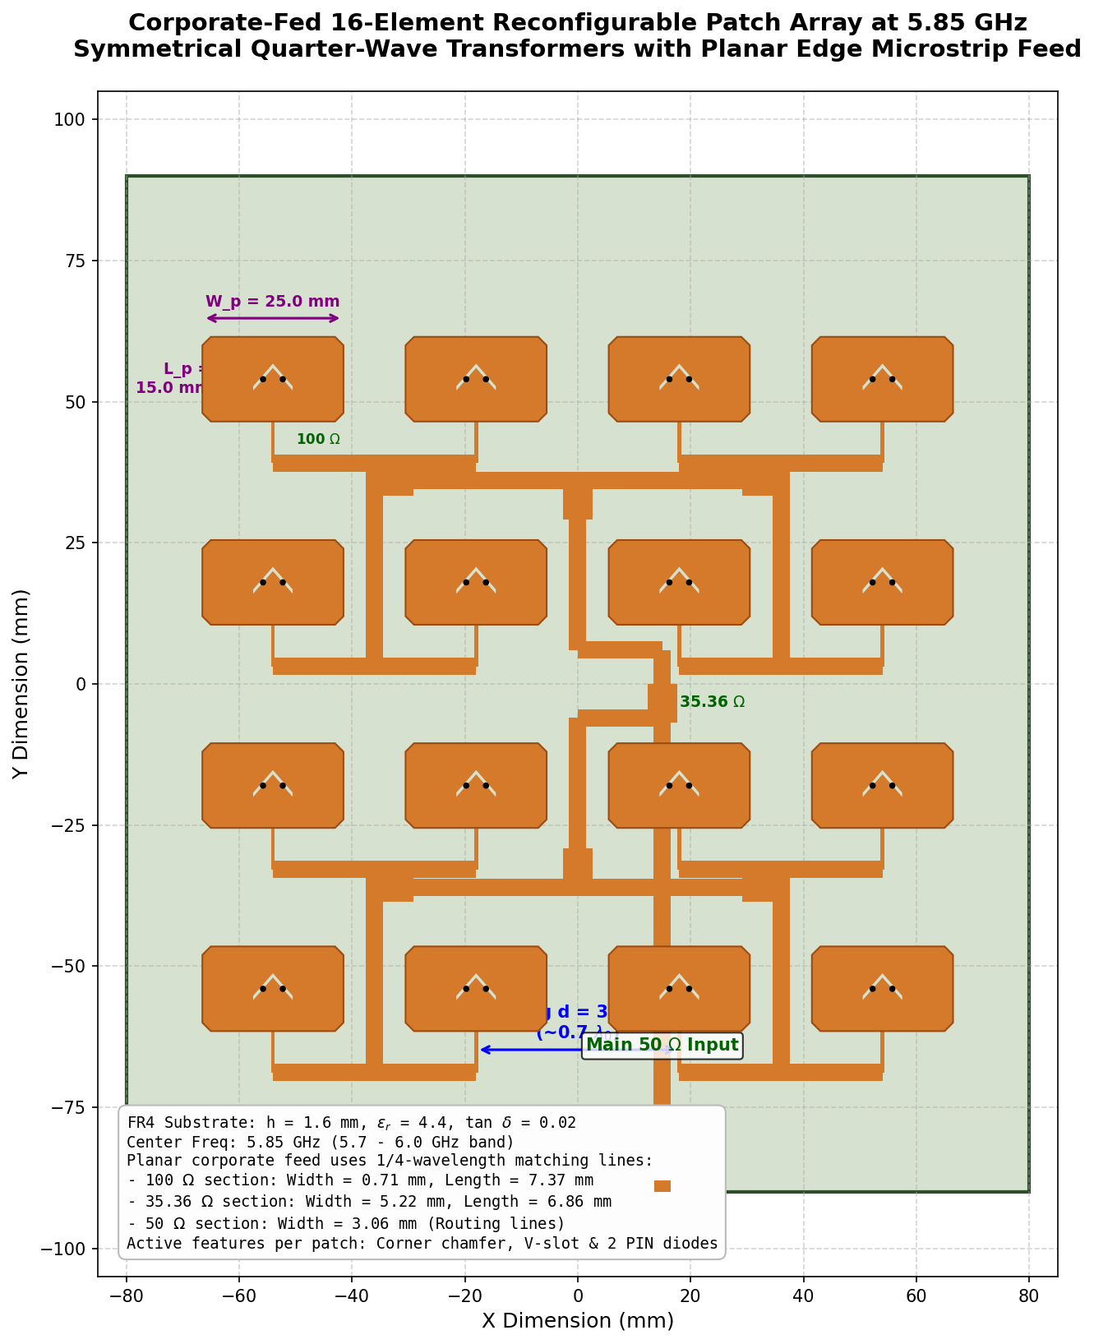
antenna/images/early_concept_reconfigurable_array.png
